mkrmx/spectre/tht/img/esquematico.png

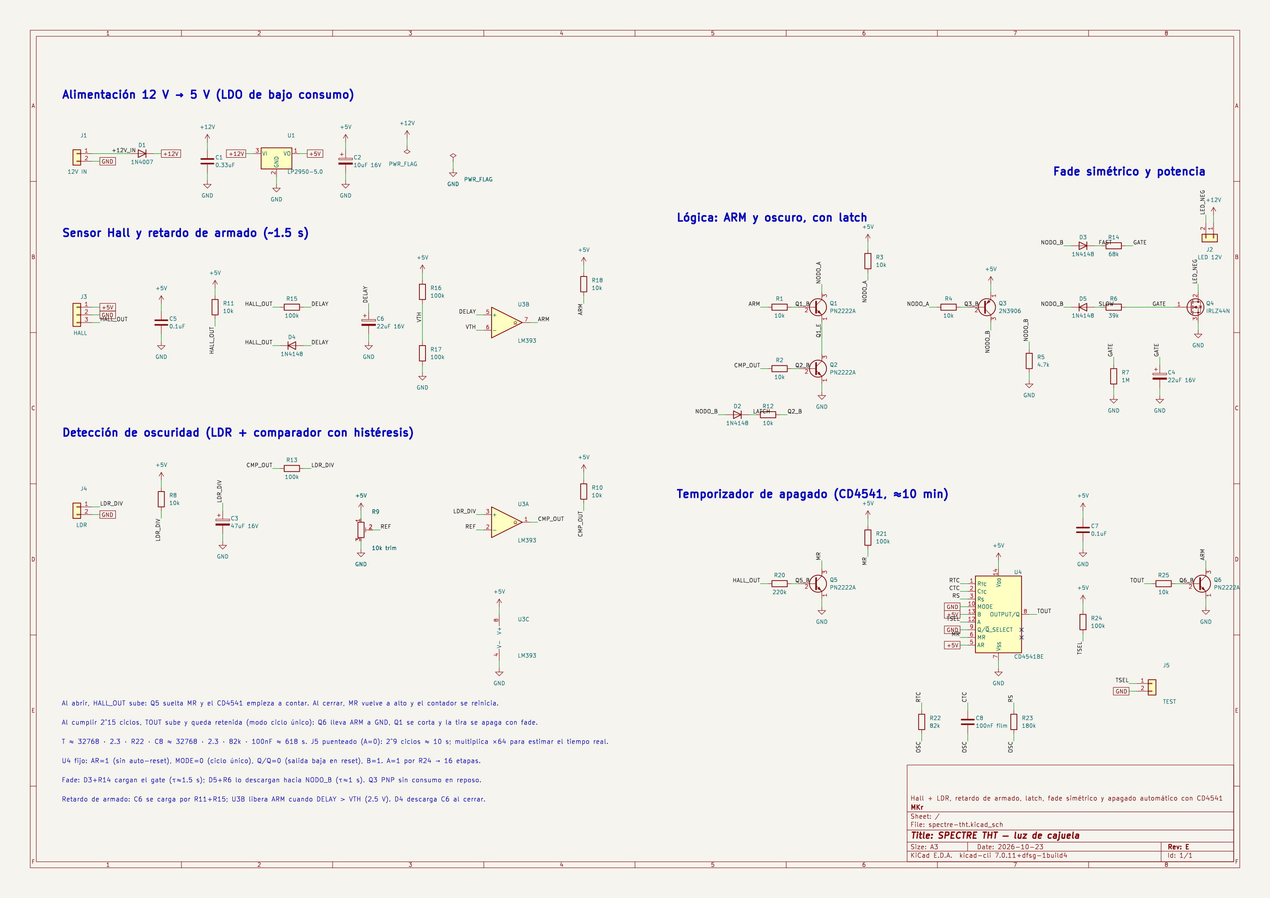
tht/img/esquematico.png
