mkrmx/spectre/tht/img/vista-inferior.png

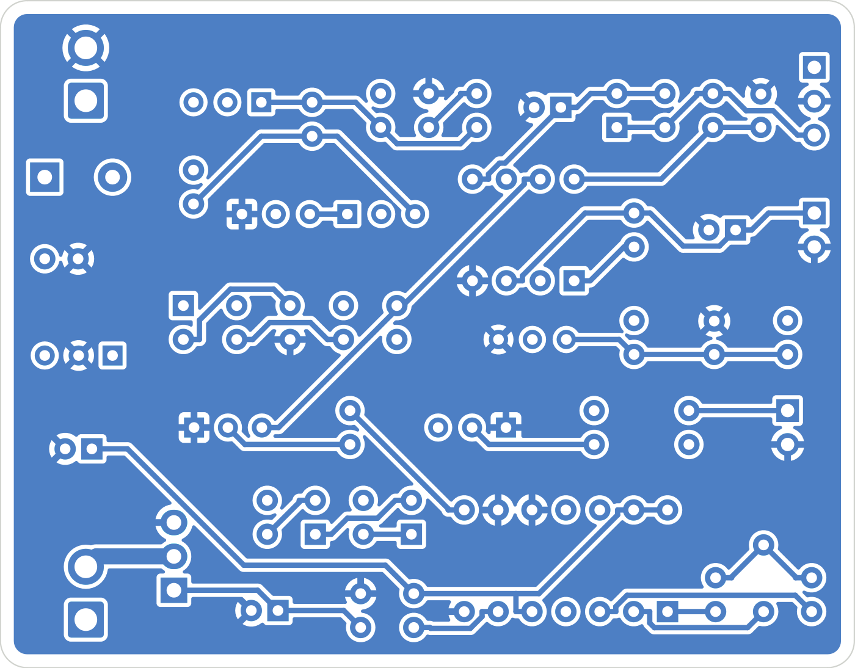
tht/img/vista-inferior.png
