mkrmx/spectre/tht/img/mapa-ensamble.png

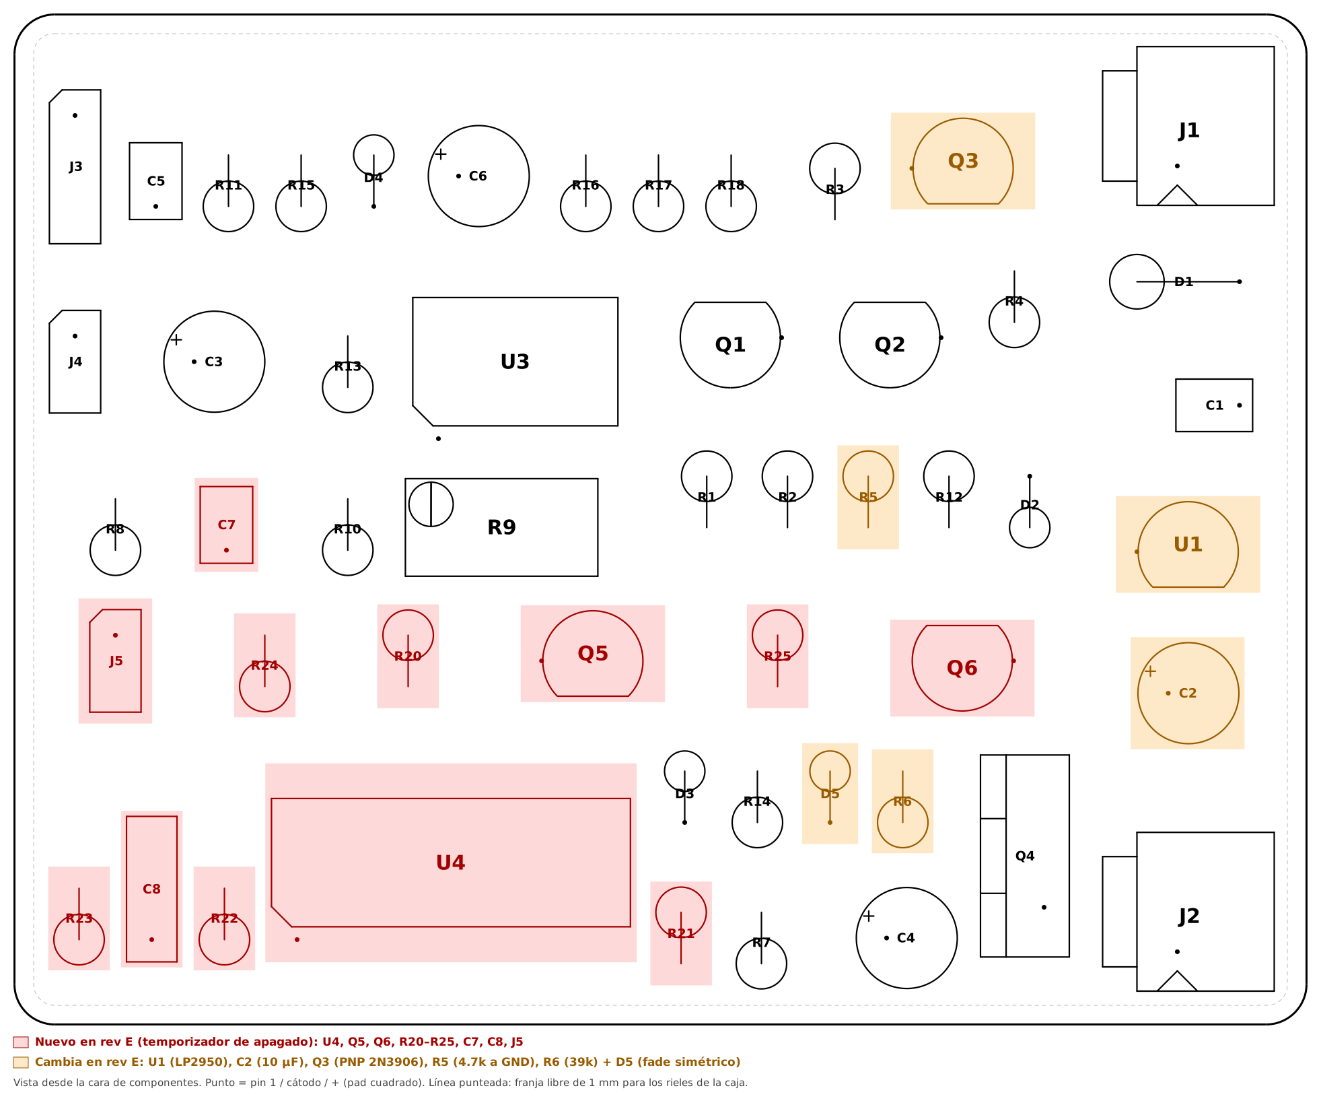
tht/img/mapa-ensamble.png
