mkrmx/spectre/tht/spectre-tht-esquematico.pdf

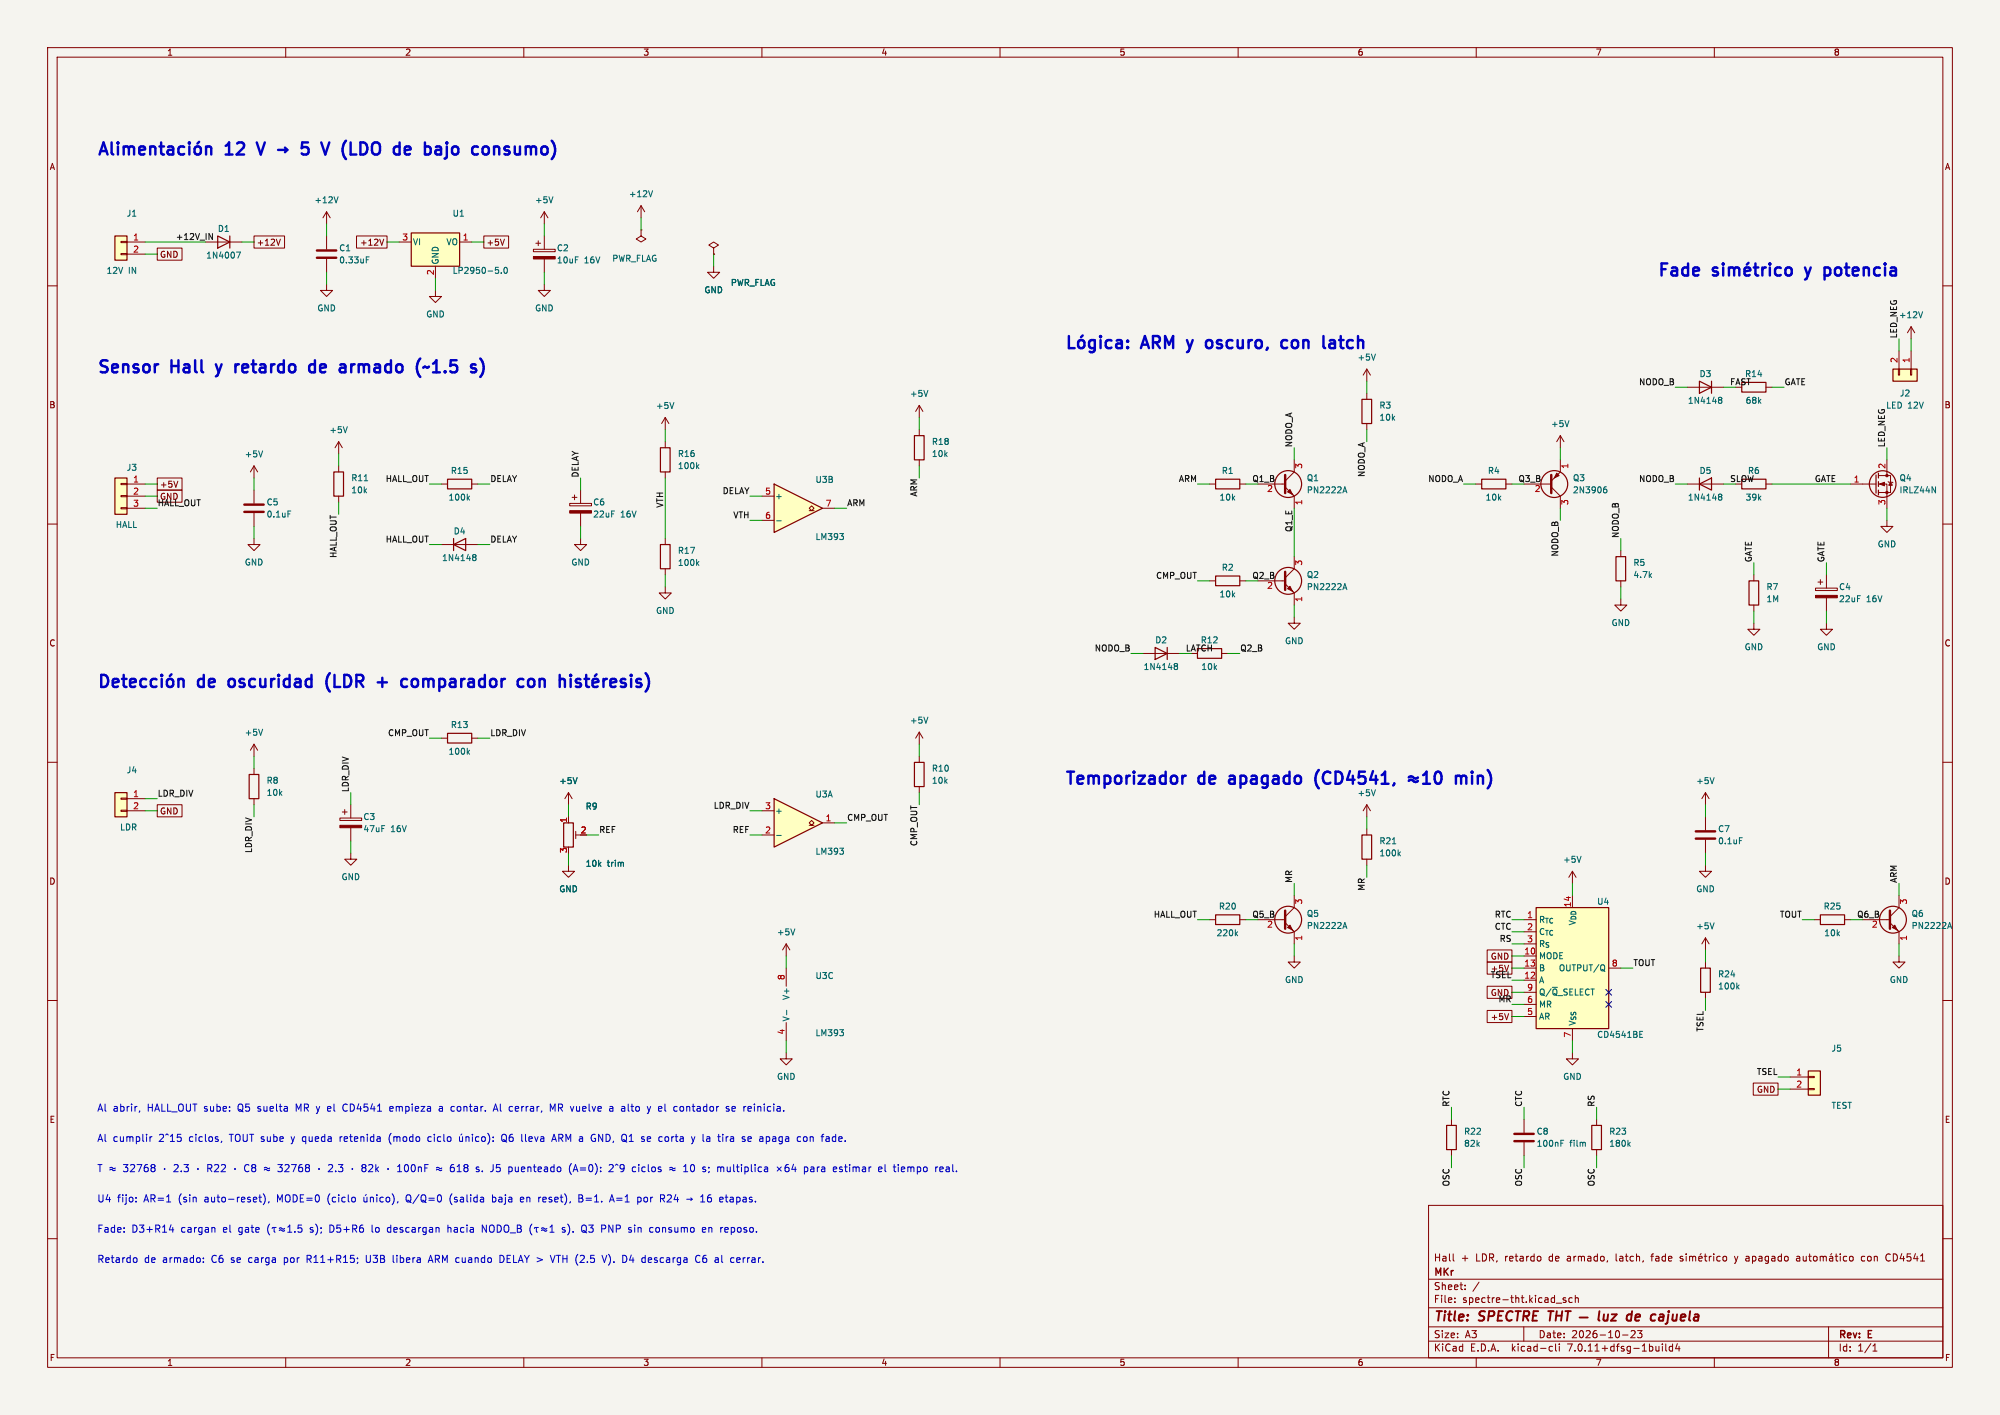
[picture p7: page 1]

þÿAlimentación 12 V þÿ!’5 V (LDO de bajo consumo)

þÿLógica: ARM y oscuro, con latch

Sensor Hall y retardo de armado (~1.5 s)

Id: 1/1 Title: SPECTRE THT þÿ luz de cajuela
