mkrmx/spectre/docs/spectre-esquematico.pdf

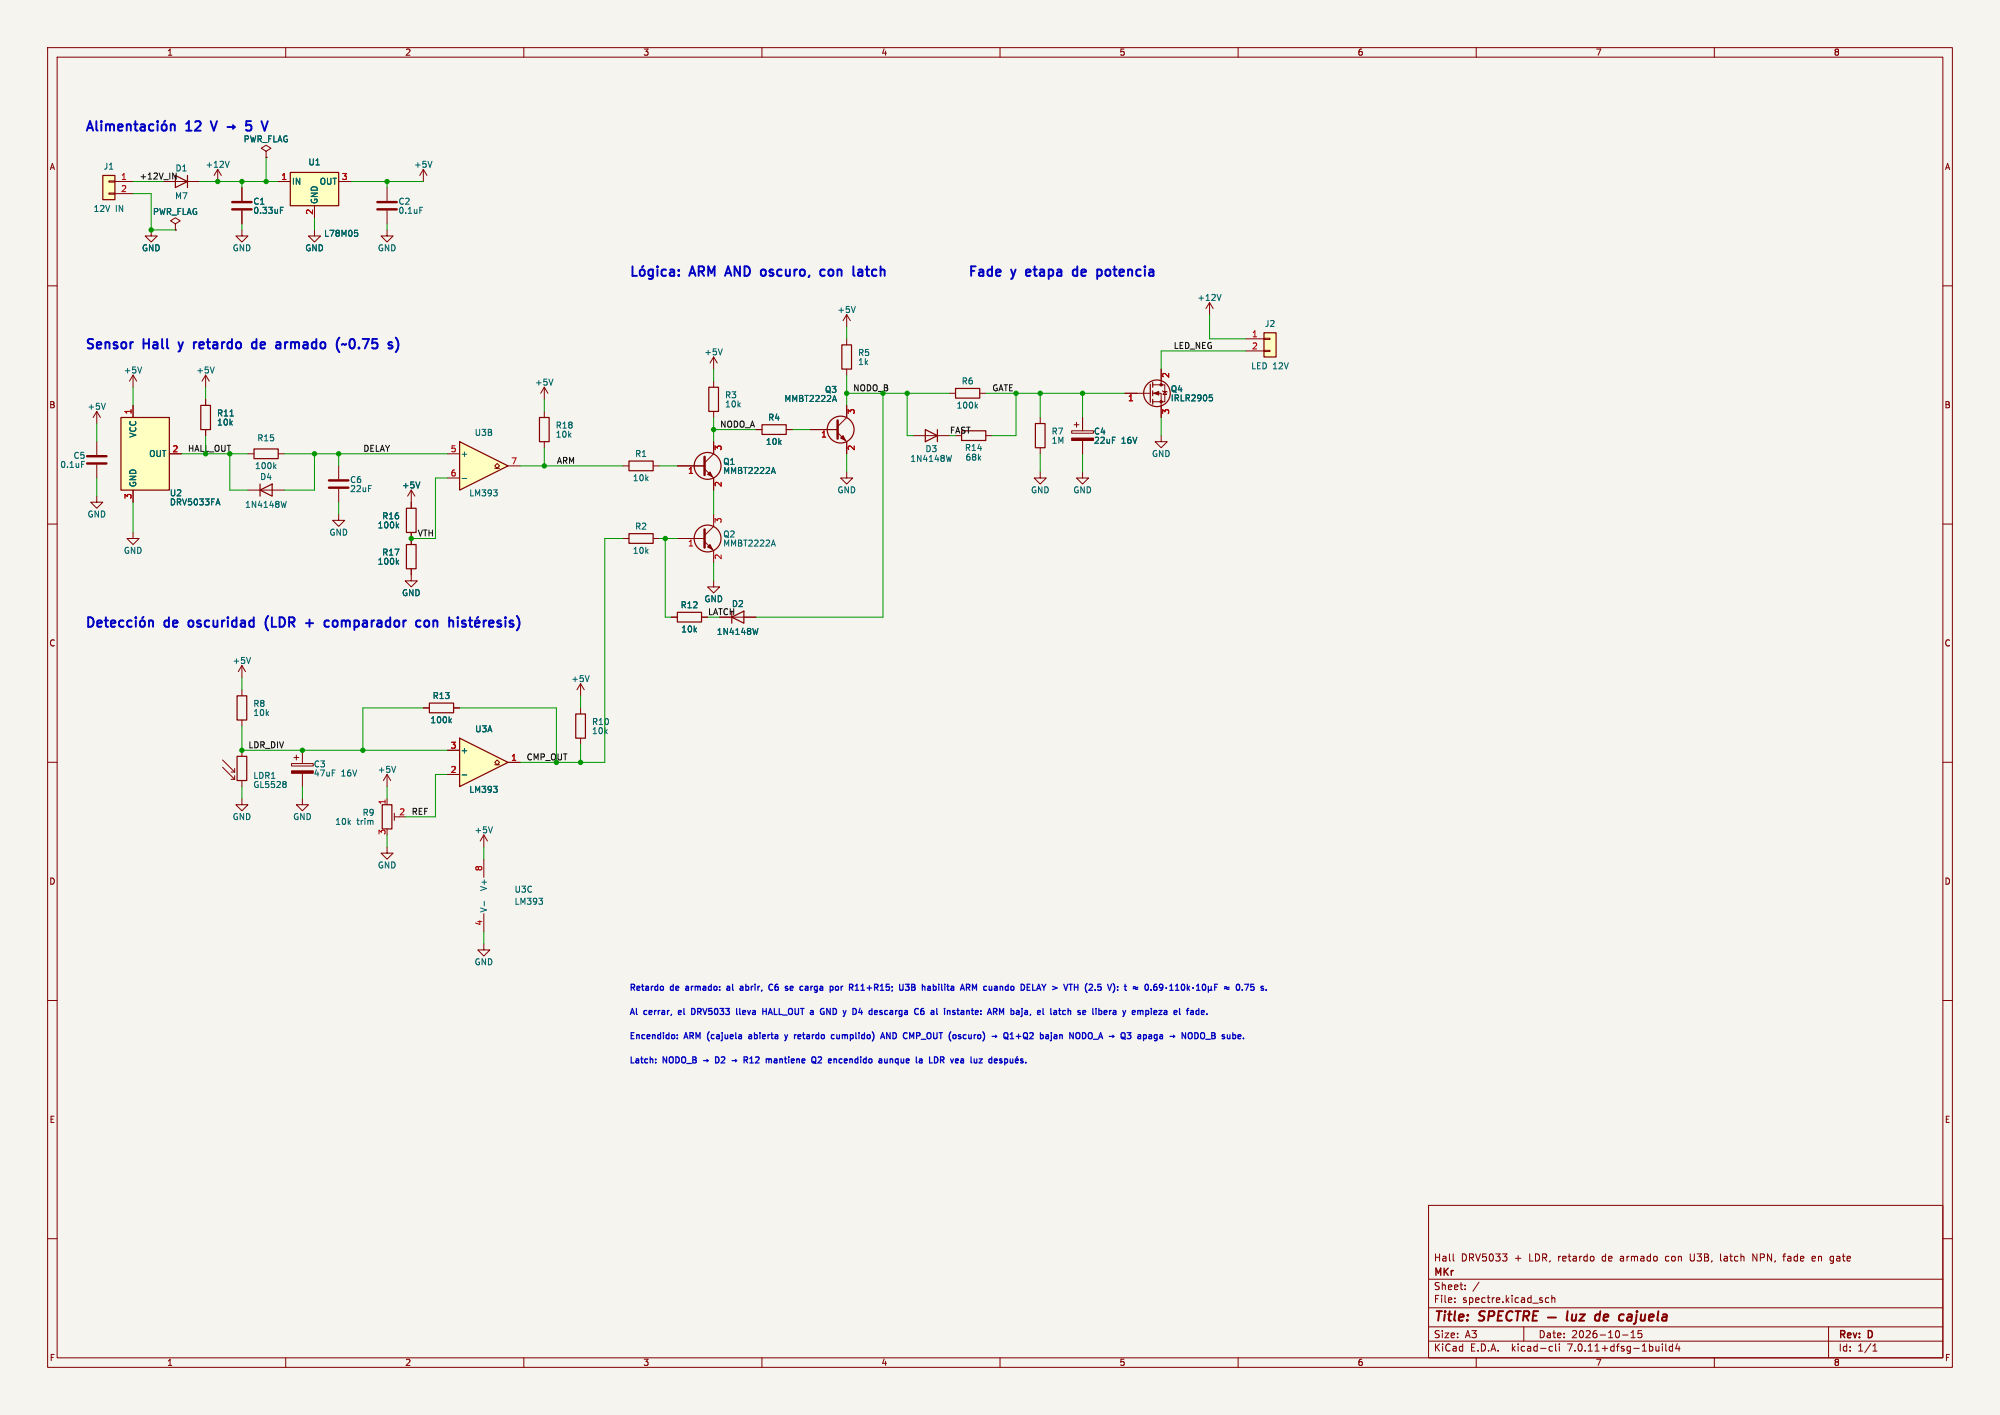
[picture p8: page 1]

þÿLógica: ARM AND oscuro, con latch

Fade y etapa de potencia

Sensor Hall y retardo de armado (~0.75 s)

Latch: NODO_B þÿ!’D2 þÿ!’R12 mantiene Q2 encendido aunque la LDR vea luz þÿdespués.

Id: 1/1 Title: SPECTRE þÿ luz de cajuela
