mkrmx/spectre/tht/spectre-tht.kicad_pcb

## KiCad design tht/spectre-tht.kicad_pcb (2026-10-28)

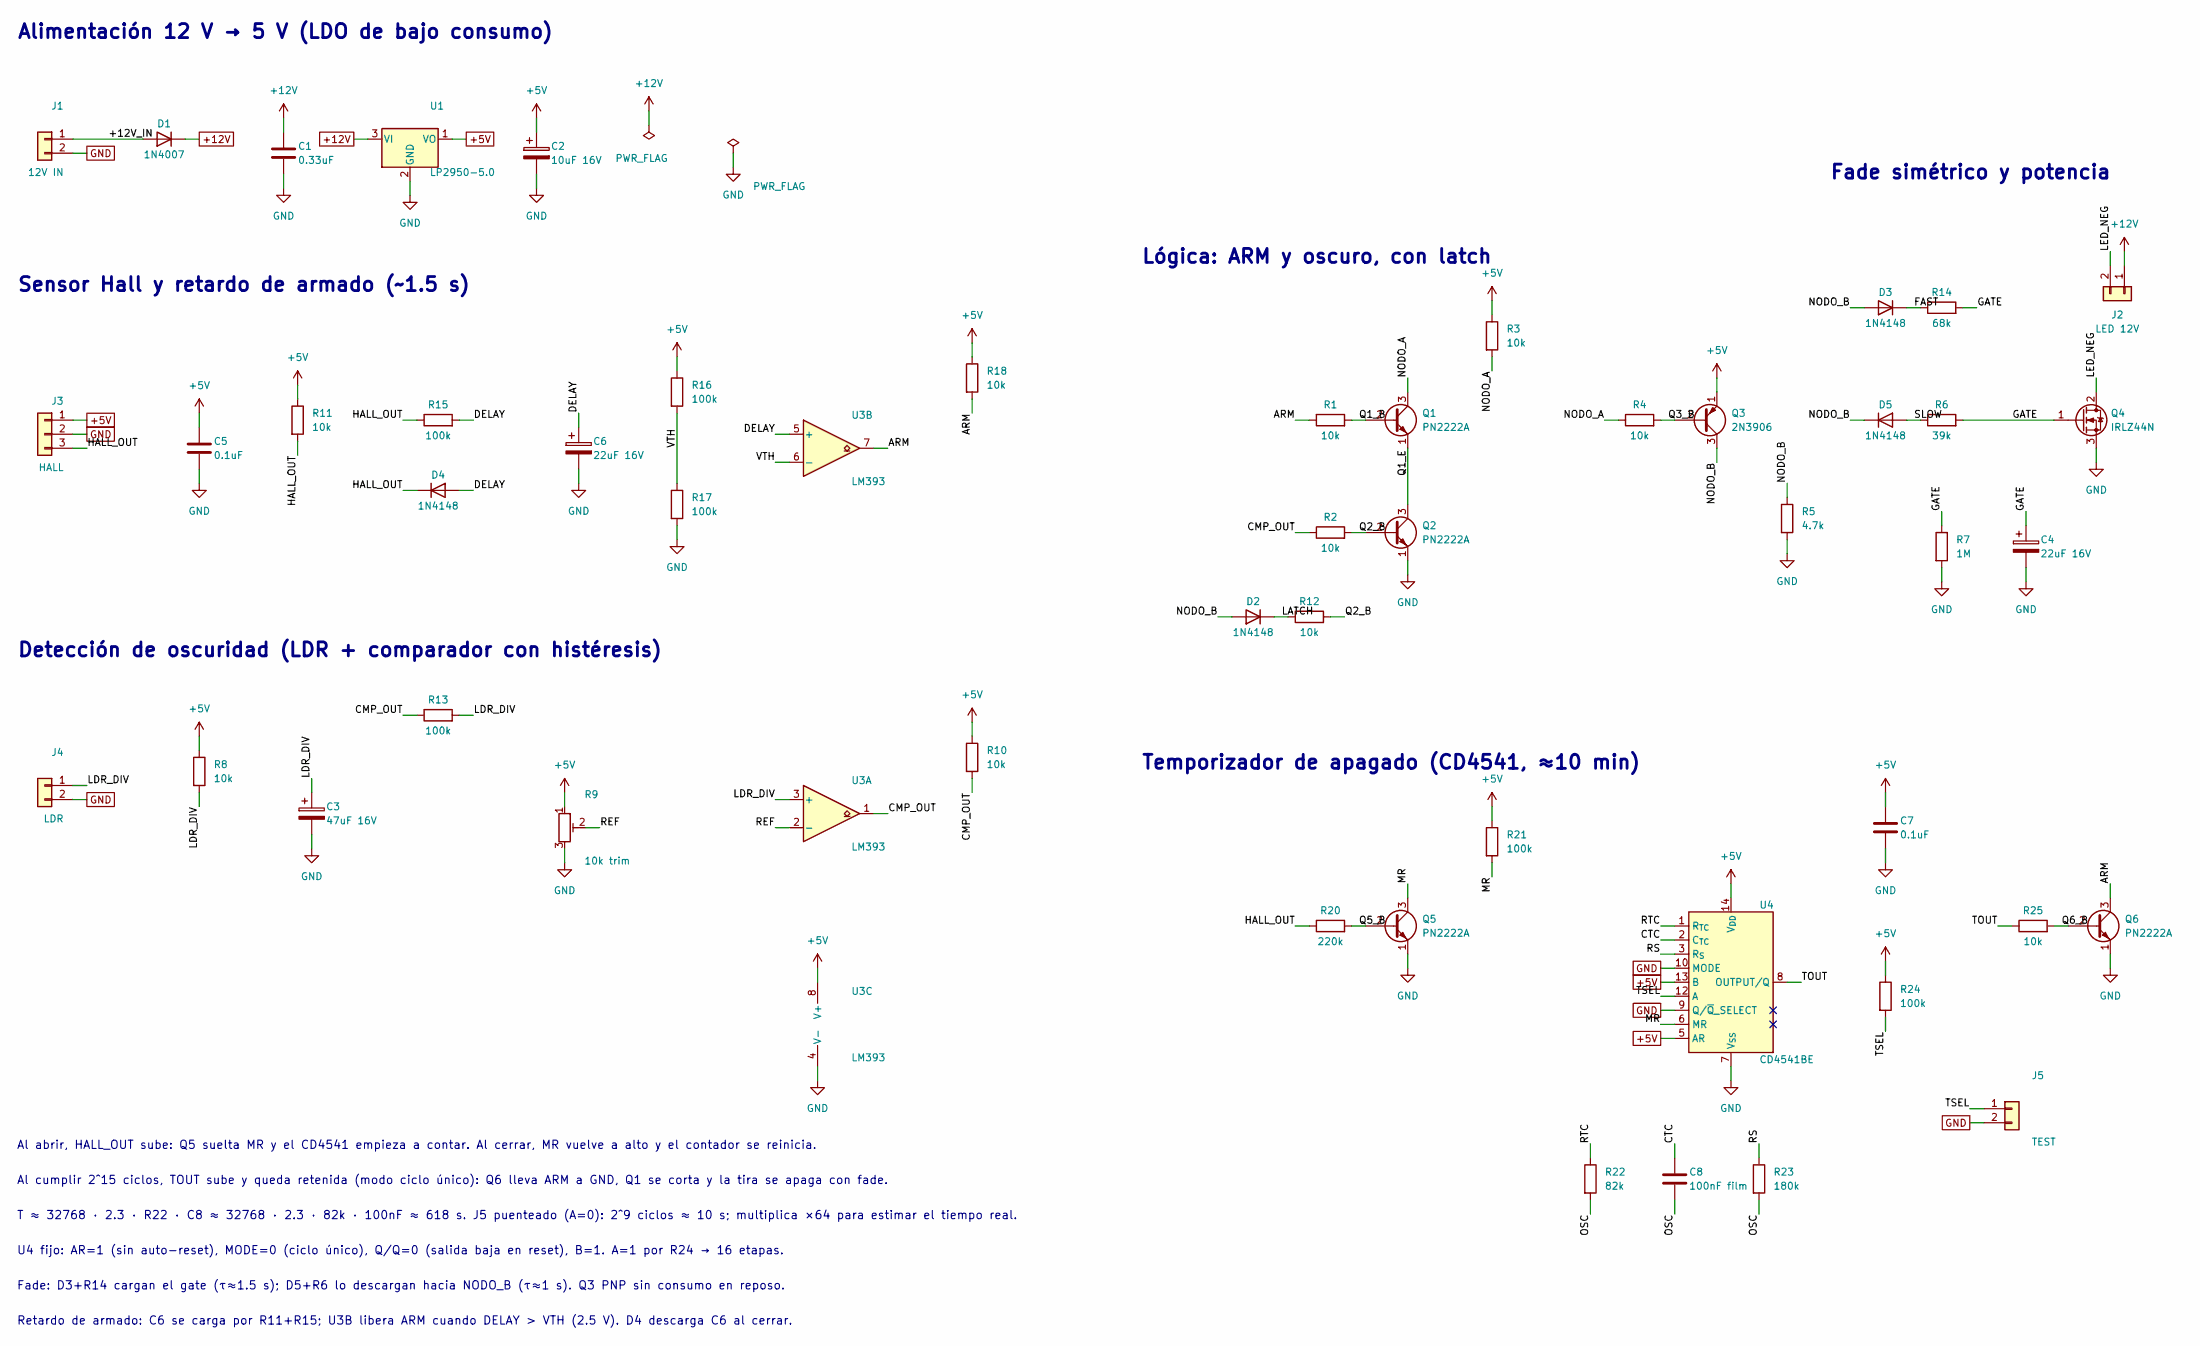
[picture p9: schematic spectre-tht.kicad_sch, SPECTRE THT — luz de cajuela]

Parts:
C1: 0.33uF; C_Disc_D3.8mm_W2.6mm_P2.50mm
C2: 10uF 16V; CP_Radial_D5.0mm_P2.00mm
C3: 47uF 16V; CP_Radial_D5.0mm_P2.00mm
C4, C6: 22uF 16V; CP_Radial_D5.0mm_P2.00mm
C5, C7: 0.1uF; C_Disc_D3.8mm_W2.6mm_P2.50mm
C8: 100nF film; C_Rect_L7.2mm_W2.5mm_P5.00mm_FKS2_FKP2_MKS2_MKP2
D1: 1N4007; D_DO-41_SOD81_P5.08mm_Vertical_KathodeUp
D2, D3, D4, D5: 1N4148; D_DO-35_SOD27_P2.54mm_Vertical_KathodeUp
J1: 12V IN; JST_VH_B2P-VH_1x02_P3.96mm_Vertical
J2: LED 12V; JST_VH_B2P-VH_1x02_P3.96mm_Vertical
J3: HALL; PinHeader_1x03_P2.54mm_Vertical
J4: LDR; PinHeader_1x02_P2.54mm_Vertical
J5: TEST; PinHeader_1x02_P2.54mm_Vertical
Q1, Q2, Q5, Q6: PN2222A; TO-92_Inline_Wide
Q3: 2N3906; TO-92_Inline_Wide
Q4: IRLZ44N; TO-220-3_Vertical
R1, R2, R3, R4, R8, R10, R11, R12, R18, R25: 10k; R_Axial_DIN0207_L6.3mm_D2.5mm_P2.54mm_Vertical
R5: 4.7k; R_Axial_DIN0207_L6.3mm_D2.5mm_P2.54mm_Vertical
R6: 39k; R_Axial_DIN0207_L6.3mm_D2.5mm_P2.54mm_Vertical
R7: 1M; R_Axial_DIN0207_L6.3mm_D2.5mm_P2.54mm_Vertical
R9: 10k trim; Potentiometer_Bourns_3296W_Vertical
R13, R15, R16, R17, R21, R24: 100k; R_Axial_DIN0207_L6.3mm_D2.5mm_P2.54mm_Vertical
R14: 68k; R_Axial_DIN0207_L6.3mm_D2.5mm_P2.54mm_Vertical
R20: 220k; R_Axial_DIN0207_L6.3mm_D2.5mm_P2.54mm_Vertical
R22: 82k; R_Axial_DIN0207_L6.3mm_D2.5mm_P2.54mm_Vertical
R23: 180k; R_Axial_DIN0207_L6.3mm_D2.5mm_P2.54mm_Vertical
U1: LP2950-5.0; TO-92_Inline_Wide
U3: LM393; DIP-8_W7.62mm
U4: CD4541BE; DIP-14_W7.62mm

Connections:
+5V: C2.1, C5.1, C7.1, J3.1, Q3.1 (E), R3.1, R8.1, R9.1, R10.1, R11.1, R16.1, R18.1, R21.1, R24.1, U1.1 (VO), U3.8 (V+), U4.5 (AR), U4.13 (B), U4.14 (V_{DD})
+12V: C1.1, D1.1 (K), J2.1, U1.3 (VI)
/+12V_IN: D1.2 (A), J1.1
/ARM: Q6.3 (C), R1.1, R18.2, U3.7
/CMP_OUT: R2.1, R10.2, R13.1, U3.1
/CTC: C8.1, U4.2 (C_{TC})
/DELAY: C6.1, D4.2 (A), R15.2, U3.5 (+)
/FAST: D3.1 (K), R14.1
/GATE: C4.1, Q4.1 (G), R6.2, R7.1, R14.2
/HALL_OUT: D4.1 (K), J3.3, R11.2, R15.1, R20.1
/LATCH: D2.1 (K), R12.1
/LDR_DIV: C3.1, J4.1, R8.2, R13.2, U3.3 (+)
/LED_NEG: J2.2, Q4.2 (D)
/MR: Q5.3 (C), R21.2, U4.6 (MR)
/NODO_A: Q1.3 (C), R3.2, R4.1
/NODO_B: D2.2 (A), D3.2 (A), D5.1 (K), Q3.3 (C), R5.1
/OSC: C8.2, R22.2, R23.2
/Q1_B: Q1.2 (B), R1.2
/Q1_E: Q1.1 (E), Q2.3 (C)
/Q2_B: Q2.2 (B), R2.2, R12.2
/Q3_B: Q3.2 (B), R4.2
/Q5_B: Q5.2 (B), R20.2
/Q6_B: Q6.2 (B), R25.2
/REF: R9.2, U3.2 (-)
/RS: R23.1, U4.3 (R_{S})
/RTC: R22.1, U4.1 (R_{TC})
/SLOW: D5.2 (A), R6.1
/TOUT: R25.1, U4.8 (OUTPUT/Q)
/TSEL: J5.1, R24.2, U4.12 (A)
/VTH: R16.2, R17.1, U3.6 (-)
GND: C1.2, C2.2, C3.2, C4.2, C5.2, C6.2, C7.2, J1.2, J3.2, J4.2, J5.2, Q2.1 (E), Q4.3 (S), Q5.1 (E), Q6.1 (E), R5.2, R7.2, R9.3, R17.2, U1.2 (GND), U3.4 (V-), U4.7 (V_{SS}), U4.9 (Q/~Q_SELECT), U4.10 (MODE)

Notes on the sheet:
Alimentación 12 V → 5 V (LDO de bajo consumo)
Sensor Hall y retardo de armado (~1.5 s)
Detección de oscuridad (LDR + comparador con histéresis)
Lógica: ARM y oscuro, con latch
Fade simétrico y potencia
Temporizador de apagado (CD4541, ≈10 min)
Al abrir, HALL_OUT sube: Q5 suelta MR y el CD4541 empieza a contar. Al cerrar, MR vuelve a alto y el contador se reinicia.
Al cumplir 2^15 ciclos, TOUT sube y queda retenida (modo ciclo único): Q6 lleva ARM a GND, Q1 se corta y la tira se apaga con fade.
T ≈ 32768 · 2.3 · R22 · C8 ≈ 32768 · 2.3 · 82k · 100nF ≈ 618 s. J5 puenteado (A=0): 2^9 ciclos ≈ 10 s; multiplica ×64 para estimar el tiempo real.
U4 fijo: AR=1 (sin auto-reset), MODE=0 (ciclo único), Q/Q=0 (salida baja en reset), B=1. A=1 por R24 → 16 etapas.
Fade: D3+R14 cargan el gate (τ≈1.5 s); D5+R6 lo descargan hacia NODO_B (τ≈1 s). Q3 PNP sin consumo en reposo.
Retardo de armado: C6 se carga por R11+R15; U3B libera ARM cuando DELAY > VTH (2.5 V). D4 descarga C6 al cerrar.

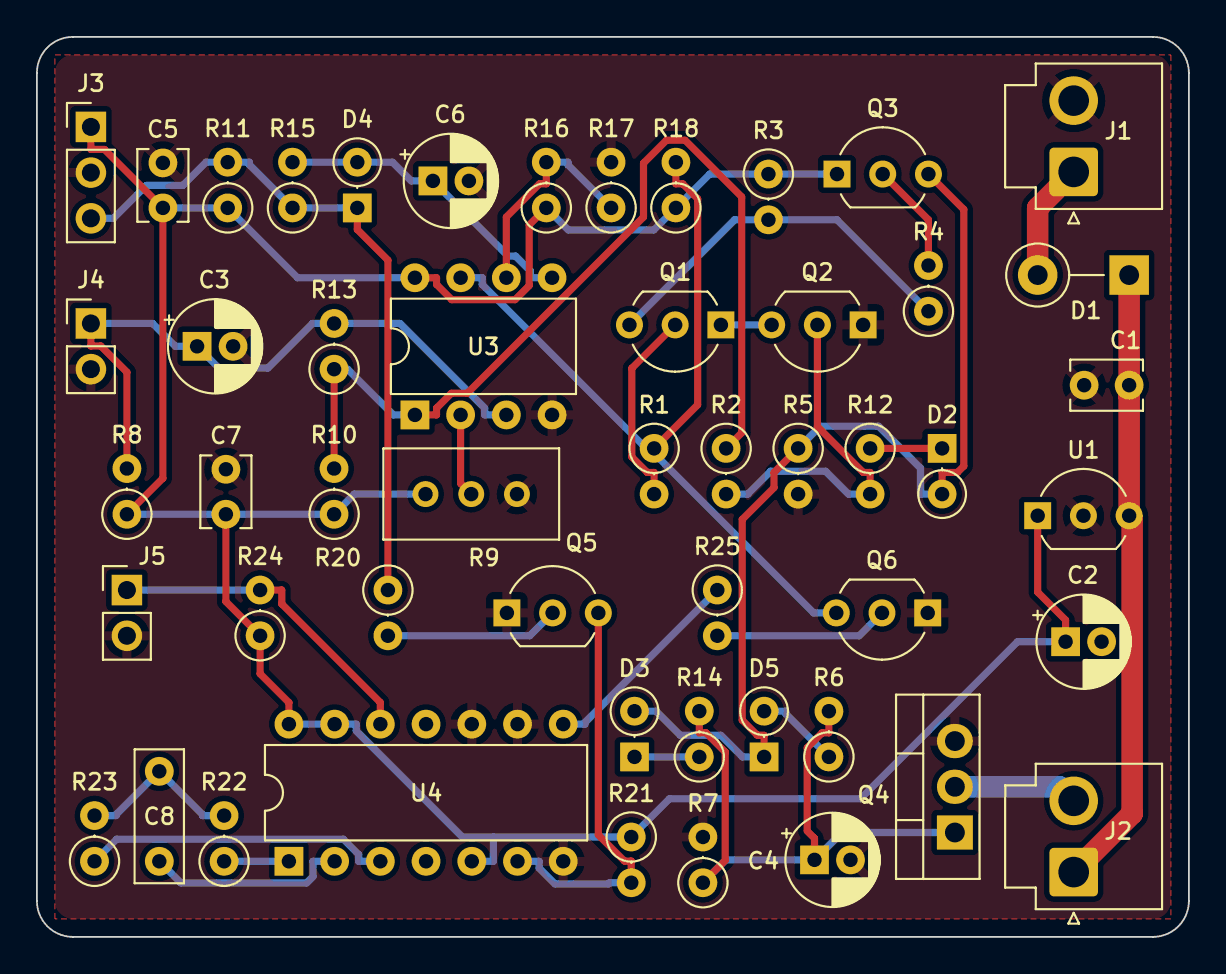
[picture p10: board spectre-tht.kicad_pcb from above]

Board: 2 copper layers, 64.0 x 50.0 mm, 51 parts (0 on the bottom side), 31 nets.
