mkrmx/spectre/(commit log)

2026-10-22 SMT rev D: proyecto KiCad, Gerbers, BOM/CPL y documentación
    Circuito con retardo de armado (U3B, R15-R18, C6 22 uF, D4), placa
    42 x 32 mm sin barrenos con franja libre de 1 mm. README con
    descripción, conexiones y decisiones de diseño; CHANGELOG con todas
    las versiones.
    Claude-Session: https://claude.ai/code/session_01NdtrgiZN4zRx2LLkVcyVwJ
2026-10-22 THT rev D: PCB 46 x 40 mm, Gerbers y lista de componentes
    Mismo circuito rev D en through-hole, Hall y LDR por cable (J3, J4),
    conectores JST VH, sin barrenos y con franja libre de 1 mm.
    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
2026-10-22 Herramientas de diseño: generación, acomodo, ruteo y verificación
    Scripts usados para rev D (SMT y THT): netlists, acomodo por recocido,
    ruteo con Freerouting, cosido de GND, serigrafía, logo, DRC,
    verificación contra la netlist y exportación. Rutas relativas al repo.
    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
2026-10-28 THT rev E: apagado automático con CD4541, fade simétrico y menor consumo
    - Esquemático propio de la versión THT (KiCad 7) y PCB de 64 x 50 mm.
    - U4 CD4541 apaga la tira ~10 min después de abrir; se reinicia al cerrar.
    - Fade con caminos separados de encendido (D3+R14) y apagado (D5+R6).
    - LP2950-5.0 y Q3 PNP: consumo en reposo de ~14 mA a ~5 mA.
    - DRC sin errores; netlist esquemático vs PCB sin diferencias.
    - Se retiran los Gerbers de rev D (siguen en la etiqueta tht-rev-d).
    Claude-Session: https://claude.ai/code/session_018mBD4zSdnh6yTbdGDUV7b8
2026-10-28 THT rev E: Gerbers y taladros
    - fab/spectre-tht-gerbers.zip: cobre, máscara, serigrafía, contorno,
    taladros Excellon (129 barrenos, sin vías), mapa de taladros y job file.
    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
2026-10-28 THT rev E: acomodo redistribuido y Gerbers regenerados
    - Conectores con el mismo margen al borde (~1.1 mm).
    - D1 y C1 horizontales; cátodo de D1, C1 y entrada de U1 en una vertical.
    - Filas alineadas: J4/C3/R13 con U3, R8/C7/R10 con R9,
    J5/R24/R20/Q5/R25/Q6 con espacio repartido; U4 y oscilador 1.5 mm arriba.
    - Mismo circuito y misma netlist; ruteo nuevo sin vías y DRC sin errores.
    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
